c-not-around/lc-meter/v2/1.jpg

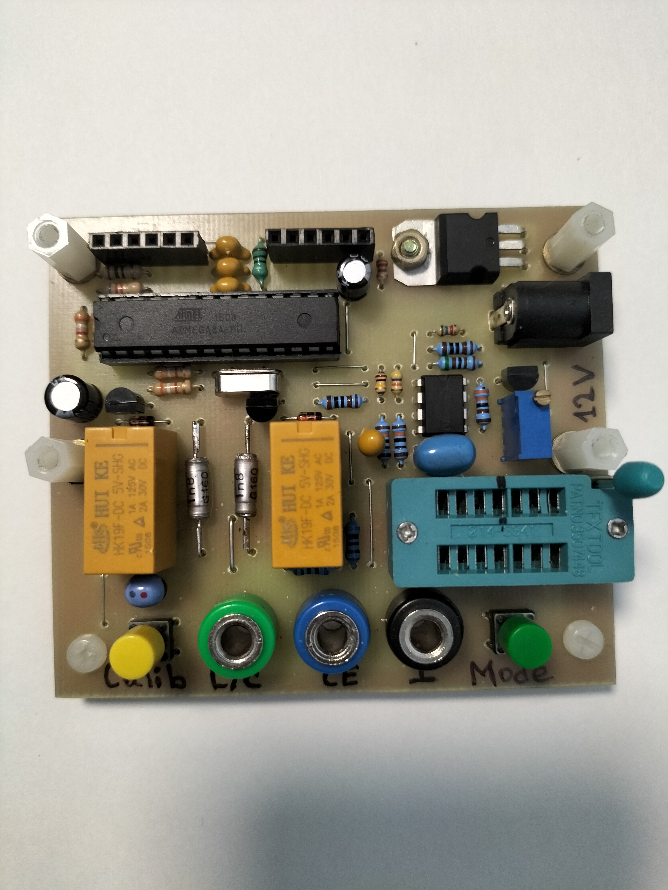
v2/1.jpg
