c-not-around/lc-meter/v2/2.jpg

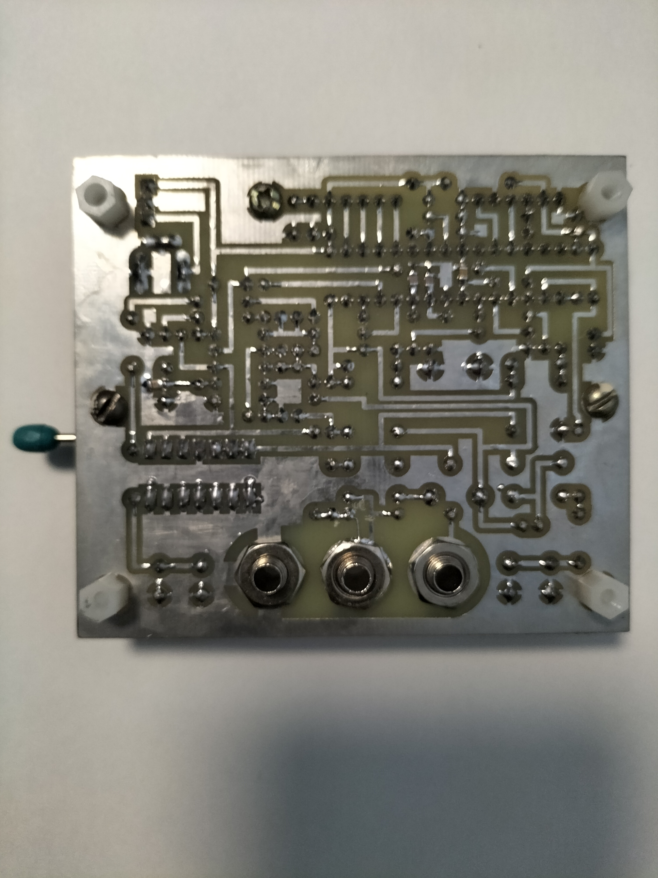
v2/2.jpg
