c-not-around/lc-meter/v2/3.jpg

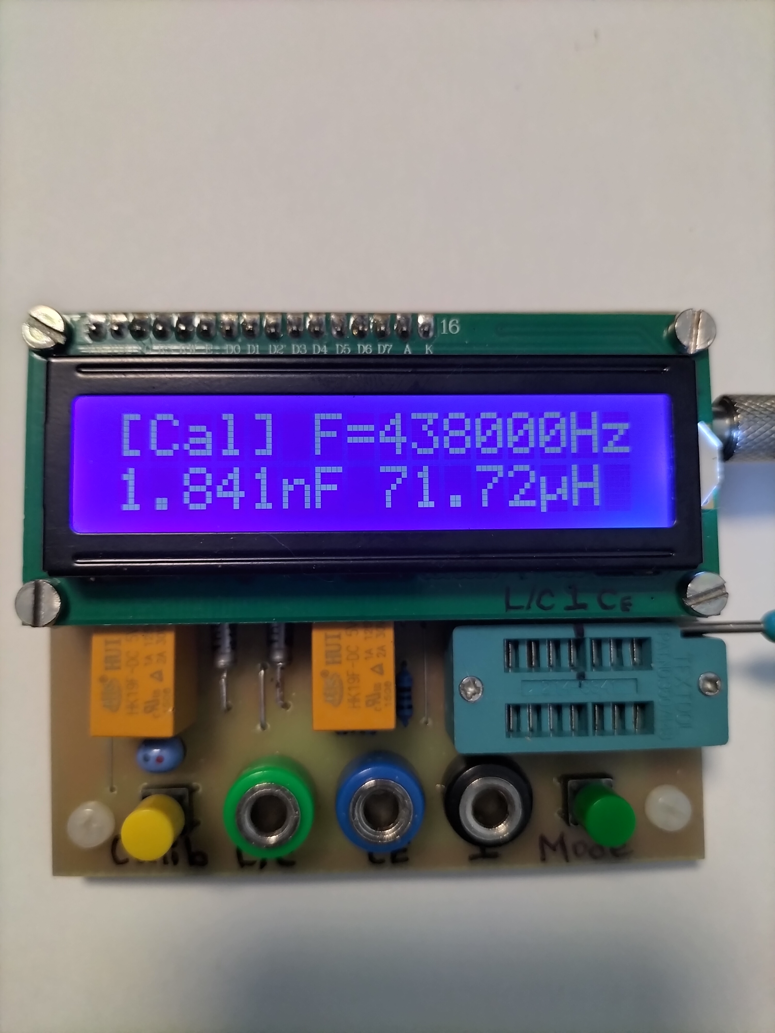
v2/3.jpg
