c-not-around/lc-meter/v2/pcb.png

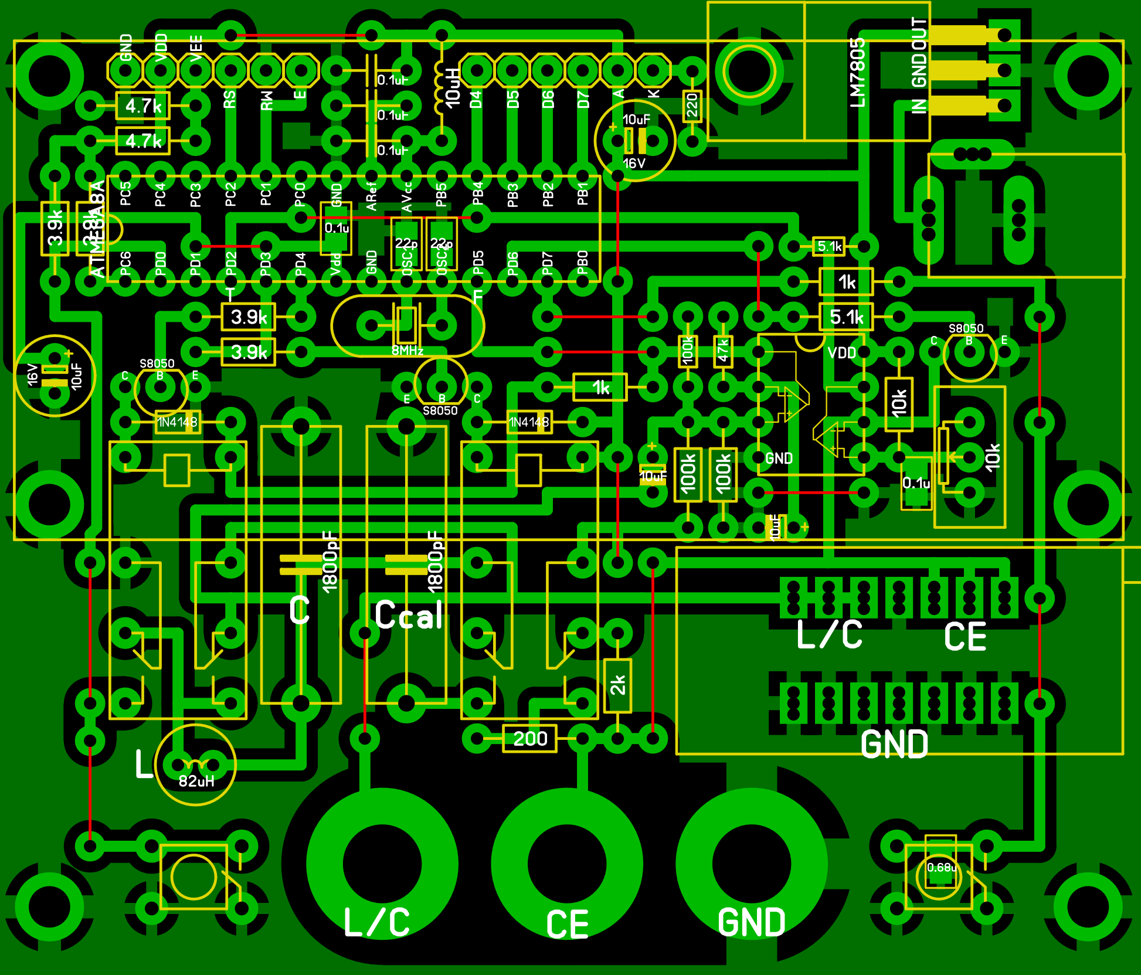
v2/pcb.png
