c-not-around/lc-meter/(list of files, drawings)

Other design files:
doc/sheme.spl8
v1/model_ce.pdsprj
v1/model_lc.pdsprj
v1/pcb.lay
v2/model_ce.pdsprj
v2/model_lc.pdsprj
v2/pcb.lay6
